MaterialFoundry/MaterialPlane_Models/UserSubmitted/Img/.thumb/MicstandMount_Official.jpg.jpg

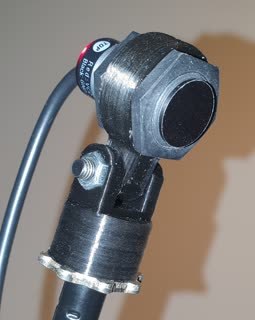
UserSubmitted/Img/.thumb/MicstandMount_Official.jpg.jpg
