MaterialFoundry/MaterialPlane_Models/README.md

This repository contains 3D models for <a href="https://github.com/MaterialFoundry/MaterialPlane">Material Plane</a>.<br>
<br>
Files in the `Base` and `Sensor` folders are official models.<br>
Files in the `ProductionTemplates` folder are solid body representations of the production hardware, meant for designing your own accessories, these designs cannot be used to build actual bases from.<br>
The `UserSubmitted` folder contains models submitted by users. Please read the readme in that folder for more info.<br>
<br>
Please visit the Material Plane <a href="https://github.com/MaterialFoundry/MaterialPlane">main repository</a> or <a href="https://materialfoundry.github.io/MaterialPlane/">documentation</a> for more info.<br>
