MaterialFoundry/MaterialPlane_Models/ProductionTemplates/README.md

These files are meant as templates for designing your own accessories for the production Material Plane hardware.<br>
The files are solid and cannot be used as normal bases.<br>
<br>
Internal magnets and other features are represented using shallow recesses.
