MaterialFoundry/MaterialPlane_Models/UserSubmitted/README.adoc

ifdef::env-github[]
:imagesdir: https://github.com/MaterialFoundry/MaterialPlane_Models/blob/main/UserSubmitted/Img
endif::[]

# User Submitted Models

This folder contains 3D models submitted by users. +
These models are not guaranteed to work or print correctly, in case of issues and/or questions, please contact the author.

## Index

### Base
[cols="^,^,^,^,^,^,^,^"]
|===
|Name | Description| Size | Download Link |Printer Type | Instructions | Author | Image

| Base | Official base with recessed top surface | 25x25x6mm | https://github.com/MaterialFoundry/MaterialPlane_Models/blob/main/Base/Base.stl[stl], https://github.com/MaterialFoundry/MaterialPlane_Models/blob/main/Base/Base.step[step] | FDM/Resin | https://materialfoundry.github.io/MaterialPlane/DIY/BuildInstructions/base/[Instructions] | Material Foundry info@materialfoundry.nl | 

| Base Flat | Official base with flat top surface | 25x25x6mm | https://github.com/MaterialFoundry/MaterialPlane_Models/blob/main/Base/Base_Flat.stl[stl], https://github.com/MaterialFoundry/MaterialPlane_Models/blob/main/Base/Base_Flat.step[step] | FDM/Resin | https://materialfoundry.github.io/MaterialPlane/DIY/BuildInstructions/base/[Instructions] | Material Foundry info@materialfoundry.nl | 

|===

### Sensor
[cols="^,^,^,^,^,^,^,^"]
|===
|Name | Subcomponent | Description| Download Link |Printer Type | Instructions | Author | Image

.5+.^|Sensor (Micro USB) | |Official 'Full Sensor' with Micro USB port  | .5+.^| FDM/Resin .5+.^| https://materialfoundry.github.io/MaterialPlane/DIY/BuildInstructions/sensorFull/[Instructions] .5+.^| Material Foundry info@materialfoundry.nl .5+.^| 
    
    | Main Body | Main body of the sensor |https://github.com/MaterialFoundry/MaterialPlane_Models/blob/main/Sensor/MainBody.stl[stl], https://github.com/MaterialFoundry/MaterialPlane_Models/blob/main/Sensor/MainBody.step[step]
  
    | Controller Bracket | Bracket to hold the microcontroller in place | https://github.com/MaterialFoundry/MaterialPlane_Models/blob/main/Sensor/ControllerBracket.stl[stl], https://github.com/MaterialFoundry/MaterialPlane_Models/blob/main/Sensor/ControllerBracket.step[step]
    
    | Sensor Bracket | Bracket to hold DFRobot sensor in place | https://github.com/MaterialFoundry/MaterialPlane_Models/blob/main/Sensor/SensorBracket.stl[stl], https://github.com/MaterialFoundry/MaterialPlane_Models/blob/main/Sensor/SensorBracket.step[step]
    
    | Lid | Lid of the sensor | https://github.com/MaterialFoundry/MaterialPlane_Models/blob/main/Sensor/Lid.stl[stl], https://github.com/MaterialFoundry/MaterialPlane_Models/blob/main/Sensor/Lid.step[step]
    
.5+.^|Sensor (USB-C) | |Official 'Full Sensor' with USB-C port  | .5+.^| FDM/Resin .5+.^| https://materialfoundry.github.io/MaterialPlane/DIY/BuildInstructions/sensorFull/[Instructions] .5+.^| Material Foundry info@materialfoundry.nl .5+.^| 
    
    | Main Body | Main body of the sensor |https://github.com/MaterialFoundry/MaterialPlane_Models/blob/main/Sensor/MainBody_USBC.stl[stl], https://github.com/MaterialFoundry/MaterialPlane_Models/blob/main/Sensor/MainBody_USBC.step[step]
  
    | Controller Bracket | Bracket to hold the microcontroller in place | https://github.com/MaterialFoundry/MaterialPlane_Models/blob/main/Sensor/ControllerBracket.stl[stl], https://github.com/MaterialFoundry/MaterialPlane_Models/blob/main/Sensor/ControllerBracket.step[step]
    
    | Sensor Bracket | Bracket to hold DFRobot sensor in place | https://github.com/MaterialFoundry/MaterialPlane_Models/blob/main/Sensor/SensorBracket.stl[stl], https://github.com/MaterialFoundry/MaterialPlane_Models/blob/main/Sensor/SensorBracket.step[step]
    
    | Lid | Lid of the sensor | https://github.com/MaterialFoundry/MaterialPlane_Models/blob/main/Sensor/Lid.stl[stl], https://github.com/MaterialFoundry/MaterialPlane_Models/blob/main/Sensor/Lid.step[step]
   
| Micstand Mount | | Simple microphone mount for the DFRobot sensor | https://github.com/MaterialFoundry/MaterialPlane_Models/blob/main/Sensor/MicstandMount.stl[stl], https://github.com/MaterialFoundry/MaterialPlane_Models/blob/main/Sensor/MicstandMount.step[step] | FDM/Resin || Material Foundry info@materialfoundry.nl | 

|===

## Submitting your own models
If you want to submit your own models, please follow these guidelines:

* Create a folder within `/UserSubmitted` with your name or some other identifier (e.g. `/UserSubmitted/Cris`). All your models will be placed inside this folder
* You can add subfolders within your folder if you want to add multiple designs (e.g. `/UserSubmitted/Cris/Base`, `/UserSubmitted/Cris/Sensor`, etc)
* Add a readme file. Please include (at least) the following:
    ** Introduction: What does your design do or how is it different from other designs
    ** Bill of materials: A list of everything that's required to build the design. Preferably this would include product numbers, links or search terms. Include clear pictures (maybe with dimensions) if you do not have a product number.
    ** Print requirements: Any special print requirements (layer height, material, printer type, etc).
    ** Assembly instructions: Step-by-step instructions on how to assemble the design, preferably with lots of pictures.
    ** Contact information: Name, email, etc
* If you have multiple designs, you would preferably have multiple readme files, one for each design (it would be good to separate your designs into multiple folders)
* Give your designs a sensible name
* Add at least a `.stl` file and preferably also a `.step` or `.obj` file
* Add your design to the index above. Please note that the file format of this readme is AsciiDoc, see https://docs.asciidoctor.org/asciidoc/latest/[here] for more info. Images that go in the table must be located in `UserSubmitted/Img`
* The repository is licensed under an open source MIT license. If you do not provide a separate license, your designs will also fall under the MIT license. You can add your own `LICENSE` file if you want

You can then do a pull request.
