MaterialFoundry/MaterialPlane_Models/UserSubmitted/Img/.thumb/Base_Official.jpg.jpg

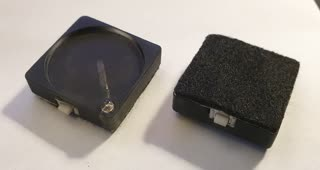
UserSubmitted/Img/.thumb/Base_Official.jpg.jpg
