MaterialFoundry/MaterialPlane_Models/UserSubmitted/Img/.thumb/Sensor_Official.jpg.jpg

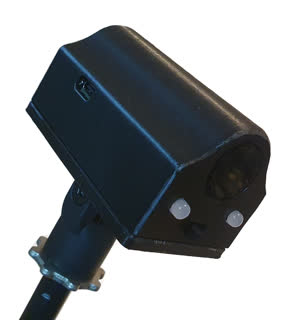
UserSubmitted/Img/.thumb/Sensor_Official.jpg.jpg
