MaterialFoundry/MaterialPlane_Models/Sensor/MainBody.step

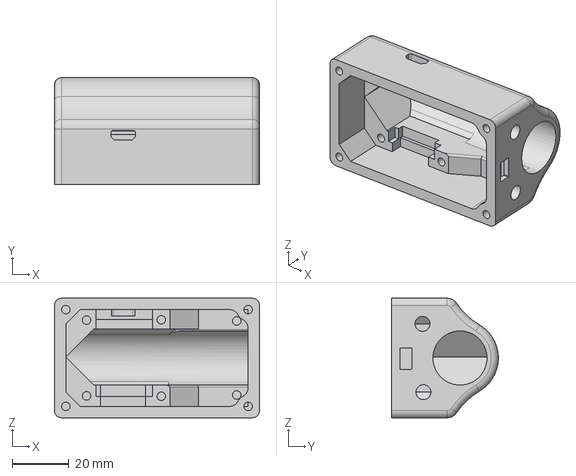
[picture p4: CAD file, 2024-02-17]
Sensor/MainBody.step
72.0 x 37.5 x 42.0 mm
