MaterialFoundry/MaterialPlane_Models/Base/Base_Flat.step

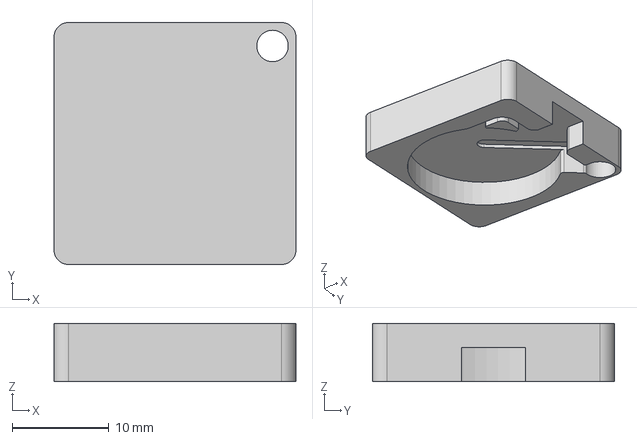
[picture p5: CAD file, 2024-02-17]
Base/Base_Flat.step
25.0 x 25.0 x 6.00 mm
