MaterialFoundry/MaterialPlane_Models/ProductionTemplates/Base.step

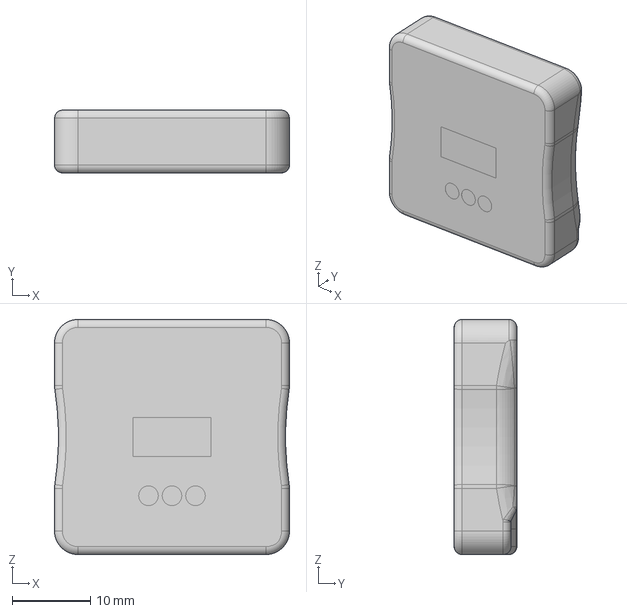
[picture p6: CAD file, 2025-08-12]
ProductionTemplates/Base.step
30.0 x 8.00 x 30.0 mm
