MaterialFoundry/MaterialPlane_Models/Base/Base.step

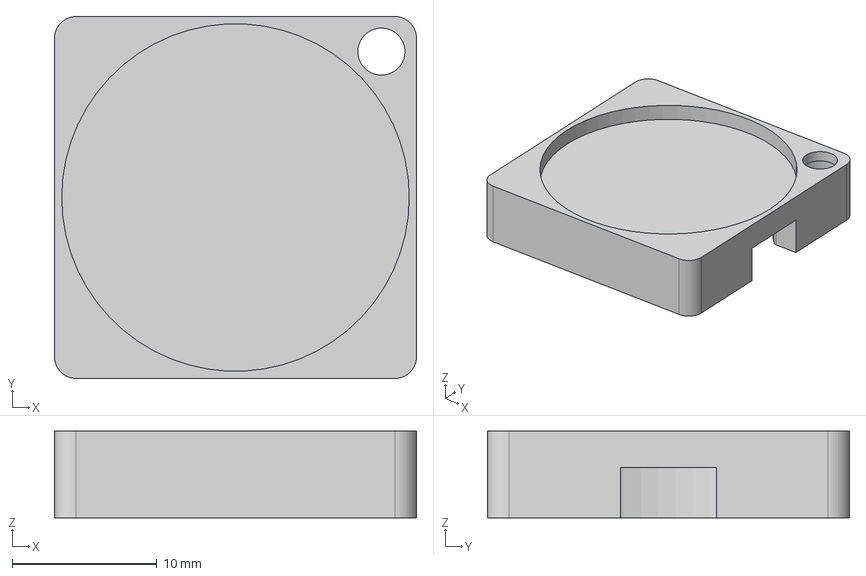
[picture p7: CAD file, 2024-02-17]
Base/Base.step
25.0 x 25.0 x 6.00 mm
