MaterialFoundry/MaterialPlane_Models/Sensor/MicstandMount.step

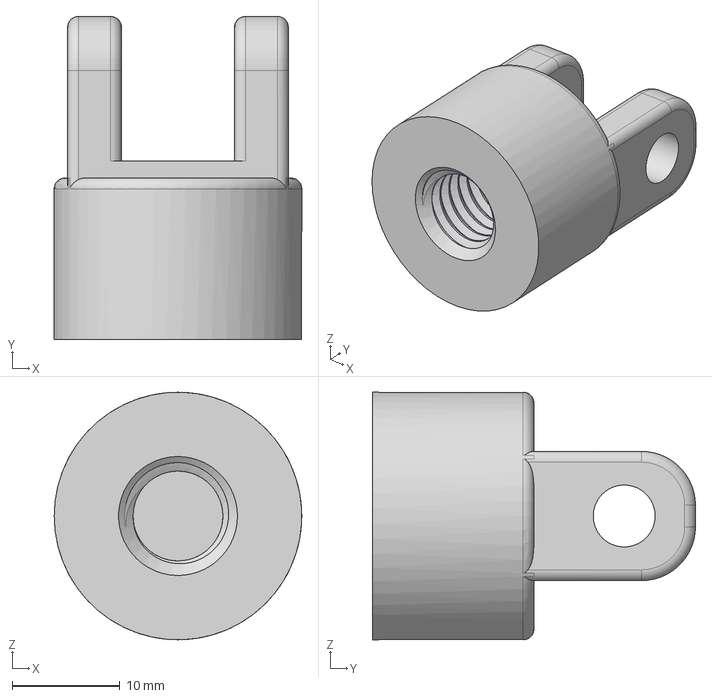
[picture p8: CAD file, 2024-02-17]
Sensor/MicstandMount.step
23.0 x 30.0 x 23.0 mm
