MaterialFoundry/MaterialPlane_Models/Sensor/SensorBracket.step

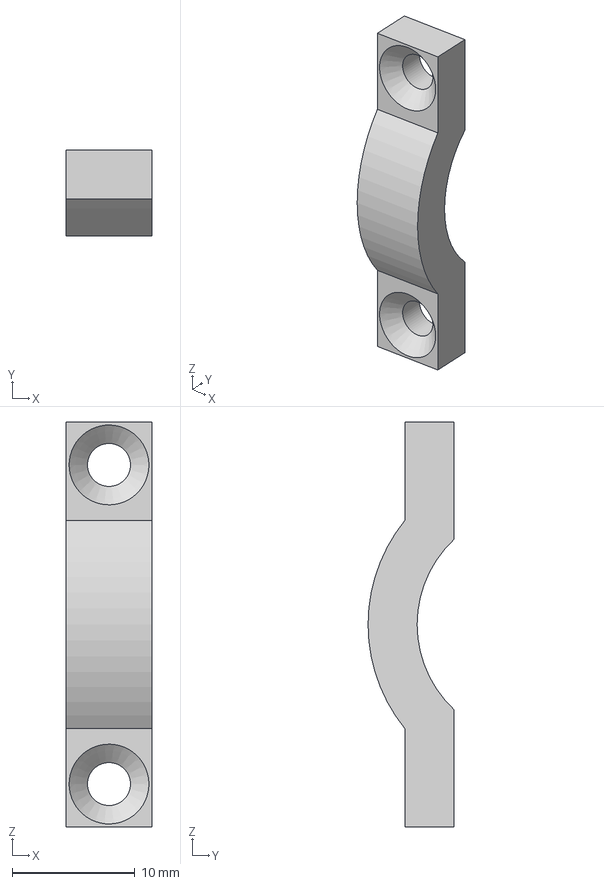
[picture p9: CAD file, 2024-02-17]
Sensor/SensorBracket.step
7.00 x 7.00 x 33.0 mm
