MaterialFoundry/MaterialPlane_Models/Sensor/ControllerBracket.step

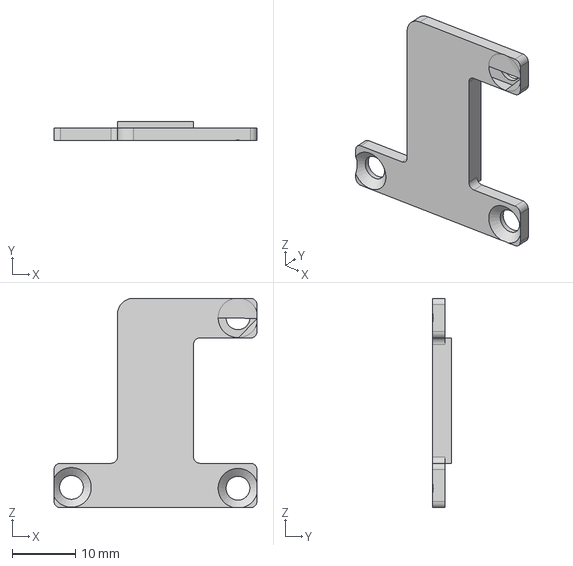
[picture p10: CAD file, 2024-02-17]
Sensor/ControllerBracket.step
32.0 x 3.00 x 33.0 mm
