MaterialFoundry/MaterialPlane_Models/Sensor/Lid.step

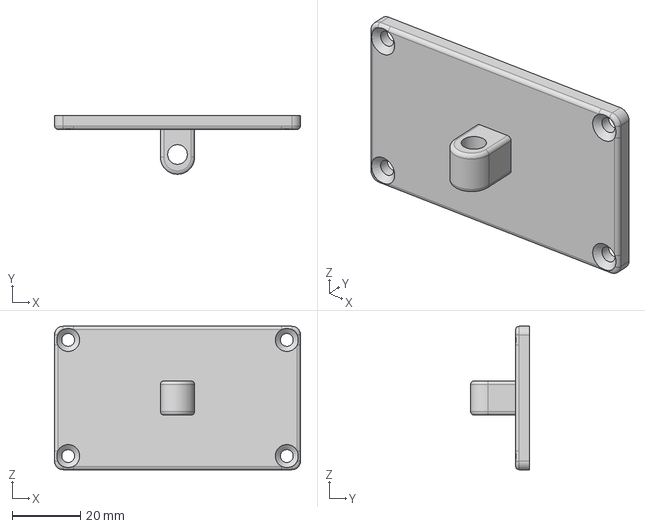
[picture p11: CAD file, 2024-02-17]
Sensor/Lid.step
72.0 x 17.2 x 42.0 mm
