MaterialFoundry/MaterialPlane_Models/(list of files, cad)

Other CAD files:
Sensor/MainBody_USBC.step
Base/Base.stl
Base/Base_Flat.stl
Sensor/ControllerBracket.stl
Sensor/Lid.stl
Sensor/MainBody.stl
Sensor/MainBody_USBC.stl
Sensor/MicstandMount.stl
Sensor/SensorBracket.stl
