MaterialFoundry/MaterialPlane_Models/(commit log)

2024-02-17 models upload
    [Base.step, Base.stl, Base_Flat.step, Base_Flat.stl, ControllerBracket.step, ControllerBracket.stl, Lid.step, Lid.stl]
2025-08-12 added production templates
    [Base.step]
